flxkrmr/eec-iv-reader-arduino/pcb/EEC-IV-Reader.png

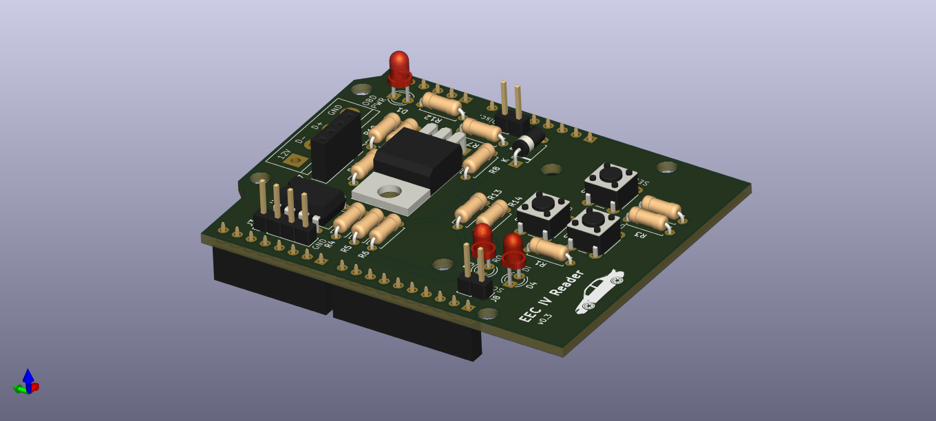
pcb/EEC-IV-Reader.png
