flxkrmr/eec-iv-reader-arduino/README.md

# Arduino EEC IV Reader

Arduino implementation of the DCL-Protocol to communicate with Ford EEC-IV ECUs.

Please check out the Wiki for more information.

This is currently a work in progress and not completely working. Use at your own risk!

Finished Board
