flxkrmr/eec-iv-reader-arduino/src/README.md

# Arduino EEC IV Reader

Arduino implementation of the DCL-Protocol to communicate with Ford EEC-IV ECUs.

Mostly based on findings of this implementation https://github.com/babroval/ford-eec-iv-diagnostic

This is currently a work in progress and not completely working. Use at your own risk!

## TODO
* Move UI code to class
* Refactor EecIv class
* Timeout for reading
* Read live values
* How to read multiple fault codes?
