flxkrmr/eec-iv-reader-arduino/(threads)

Thread 1 (2022-02-24):

hardware to read eec

fmcwb, 2022-02-24:
Hi flxkrmr,

what hardware are you using to test the eec-iv protocol? I have arduino mega 2560 for use, to using more UARTS...

I see you using the tft display... I intend to use the serial to handle the read data.

Thank You.

flxkrmr, 2022-02-25:
Hi,
currently I am using a Arduino uno attached to a rs485 board. As the uno only has one serial modul I wanted to attach a display to get some reading. But over the time I switched to using arduinos software serial as it is easier to time right for the eec iv ecu. This is why I also switched back to usb-serial output for debugging.
At the moment this is still in a very early development stage and thats why I don't want to add any circuits or manuals on how to set this up (yet). But as you can see in the main ino file, these are the pins that I currently use for the RS485 module:

```
static const int DI=3;
static const int RE=6;
static const int RO=2;
```

Closed 2022-10-07.

Thread 2 (2022-10-07):

Create circuit

flxkrmr, 2022-10-07:
To Test:
- [x] Original Board
- [x] Power Cirucit
- [x] RS485 Cirucit

flxkrmr, 2022-10-07:
Findings from tests:
* Add jumper to detach obd2 power supply for USB Power supply

Closed 2022-10-07.

Thread 5 (2022-10-23):

Improvements for Board v3

flxkrmr, 2022-10-23:
Parts:
- [x] Brückchen
- [x] Better Sockets for display
- [x] Spacers for display

Board:
- [x] Resistor names next so resistors and not under
- [x] Print name and symbol on board
- [x] Add on off switch (maybe?)
- [x] Solder points instead of screw terminals for obd cable
- [x] Led for incoming signal like logic analyzer (with label)
- [x] Lables on pin bars (debug i2c and so an)
- [x] Version on Board

Closed 2022-12-31.

Thread 8 (2022-10-28):

Readable Fault codes

flxkrmr, 2022-10-28:

flxkrmr, 2022-10-30:
Due to the limited ram of the arduino uno, it is not possible to put all the fault code strings into the code.

It could work if we switch to an arduino mega board with 4 times the memory, but that is not planned for now

Closed 2022-10-30.

Thread 15 (2023-01-08):

Display stops working occasionally

flxkrmr, 2023-01-08:

flxkrmr, 2023-02-06:
The seems to be a problem with the display. Maybe improve connection or add 4 spacers.

flxkrmr, 2023-03-18:
This might be a bigger issue, as it occurs often when testing in the car.

Thread 17 (2023-01-21):

Switch to ABLE Buttons to save memory

flxkrmr, 2023-01-21:
https://www.jsware.io/able-buttons/#:~:text=Memory%20Usage,-The%20AbleButtons%20basic&text=Maximum%20is%2030720%20bytes.,Arduino's%20built%2Din%20Debounce%20example.

Closed 2023-01-26.

Thread 23 (2023-02-06):

Add reverse polarity protection

flxkrmr, 2023-02-06:

flxkrmr, 2023-02-06:
- Reverse polarity protection
- esd protection
- gpio led
- smd parts??

Thread 25 (2023-02-17):

Need to implement parity checking for UART messages

mercury64, 2023-02-17:
As an example, the UART command to start CART is 0x4.
The module id is 0x1, the EEC node on the bus.
The last byte is the parity check byte.
Simply AND all the bytes together:
0x00...0x01, 0x04, 0x00, 0x00, 0x00 = 0x05

Command 0x04 go into CART mode.
Command 0x05 is use alternate calibration.
Command 0x80 is go permanently offline
Command 0x82 is echo module id

flxkrmr, 2023-02-17:
Do you mean the start message mentioned here https://github.com/flxkrmr/eec-iv-reader-arduino/issues/24?

These commands are interesting! Do you have more informations about the UART mode or some documents?

mercury64, 2023-02-18:
Yes, I have documents, as well as I have decompiled my EEC and have the code that runs on the EEC.

Thread 27 (2023-02-17):

Allow ECUs that start with 19200 bauds

flxkrmr, 2023-02-17:

mercury64, 2023-02-18:
As far as I know, the initial UART message starts at 2400 baud for all.
The request is made to put in CART mode 0x04 using 2400 baud.
Then depending on the EEC strategy configuration, CART mode is at 19200 baud.
Once in CART mode, the baud can be changed 2400,  4800, 9600, or 19200.
Command code 0x81, DCL_DM_SetCommLinkBAUDRate                  # Set DCL baud rate
in CART mode changes the EEC baud rate.

flxkrmr, 2023-02-18:
The code currently only works with CART mode that starts with 9600 baud and is has trouble with units that start CART mode with 19200 baud. After CART initialisation it always switched baud rate to 2400 for all diagnostic communication.

Do you know if all diagnostic commands work with all baud rates? I had trouble getting the error codes with 9600 baud, but I found nothing about this in the docs.

mercury64, 2023-02-18:
UART mode is only 2400.
You can only start CART mode in UART mode at 2400.
CART mode will start in whatever the EEC is programmed to.
CART mode can be changed once in this mode to 2400, 4800, 9600, or 19200.

I am unable to get any communication happening right now, probably a noisy circuit.

flxkrmr, 2023-02-19:
In my tests the communication seemed very resistant against noise or bad cable connections. Maybe check the delays between bytes and IWs. The EEC IV is more unforgiving with these

mercury64, 2023-02-20:
EEC-IV hardware code SME-105, software code ENVY once in cart mode starts in 9600.

What hardware code you have, and software code?

I can decompile for you, and show the code in the EEC.
UART command code 0x04= GO CART MODE:
`5a6d: d7,19               jne   5a88             if (R33 = 4)  {
5a6f: 91,08,df            orb   Rdf,8            B3_Rdf = 1;
5a72: b1,02,32            ldb   R32,2            R32 = 2;`
R32 = 2 = 0x2H = 9600baud
# 00H                2400 baud
# 01H                4800 baud
# 02H                9600 baud
# 03H               19200 baud

flxkrmr, 2023-02-20:
How do I find the hardware- and software-code?

mercury64, 2023-02-20:
Software code, or calibration is the 3 or 4 digit bold uppercase letters and numbers located on the actual EEC label.
The hardware code is not bold, can start with SME-xxxx, SDxxxx, MAF-xxxx, MLP-xxx, etc.

Post a picture of your EEC-IV label.

flxkrmr, 2023-02-21:
My main testing ECU is VANE SME-401. This one starts in 9600 baud.
The ECU that starts in 19200 is BEAU SME-105.
And lastly one ECU that does not answer at all is 2GEA EST-230

mercury64, 2023-02-22:
The 2GEA EFI-SD230 must have the 81C62 chip.
More than likely it only has  81C61 chip.
For DCL needs the second crystal that runs at 4.9152Mhz and the 81C62 CART chip.

I'll try and find the VANE and BEAU bins and will disassemble them with DCL UART/CART info. I will check in my own repository and will create a pull request.

mercury64, 2023-02-22:
Here is first commit of disassembled SME-401.
Have a read, I will update it more later.
It is fairly well commented.

Here are some links:
External Interupt from UART/CART serial data
https://github.com/mercury64/eec-iv-reader-arduino/blob/master/hardware/SME-401/SEAL_lst.txt#L5742

UART MODE
https://github.com/mercury64/eec-iv-reader-arduino/blob/master/hardware/SME-401/SEAL_lst.txt#L5754

CART MODE
https://github.com/mercury64/eec-iv-reader-arduino/blob/master/hardware/SME-401/SEAL_lst.txt#L5829

DEFINED EEC-IV DIAGNOSTIC MODES
https://github.com/mercury64/eec-iv-reader-arduino/blob/master/hardware/SME-401/SEAL_lst.txt#L6316

flxkrmr, 2023-02-22:
Damn, thats interesting. Thanks for this. Event though I'm not so good at reading assembler, I think I can pull some infos out of this

mercury64, 2023-02-22:
Comments are on the right hand side. I only commented the DCL stuff. I copied it from my EEC-IV SD48b KID2 v8 351w E4OD(Canadian). I've been disassembling it for about 3 years. The DCL code is near identical.
I'll push my documentation.

Thread 29 (2023-02-23):

Continuous Memory Errors are deleted after KOEO run

flxkrmr, 2023-02-23:
It seems that all Errors in the Continuous Test Memory (Diagnostic mode 0x26) are delete after running the KOEO test (0x25).

@mercury64 Do you by any chance know something about this?

mercury64, 2023-02-24:
First thought is, that continuous memory codes are stored in Keep Alive Memory(KAM), yellow power wire on EEC.
If power is disconnected, the codes are gone.
Give me a few days, I finally have communication going with correct delays, CART mode working with UNO and software serial.
I'll test it over this weekend.

flxkrmr, 2023-02-24:
Power is not disconnected, so this should not be the problem.

I just found something in one of your documents, which might be the cause:
"If STI is ungrounded during the output of codes in Engine Off Test, all continuous
      self  test  codes are erased from KAM.  This allows for repair verification by the
      mechanic."

All tests where run on Ford Mondeo mk1 where STI is not connected at all

mercury64, 2023-02-24:
Yup, that would explain that.
Here is a link to more documentation:
https://drive.google.com/drive/folders/1UnA8qP_5oNhmdacBlSEwCUKwn0QFDHdr

flxkrmr, 2023-02-24:
Thanks!

Closed 2023-02-24.
