flxkrmr/eec-iv-reader-arduino/pcb/schematic.pdf

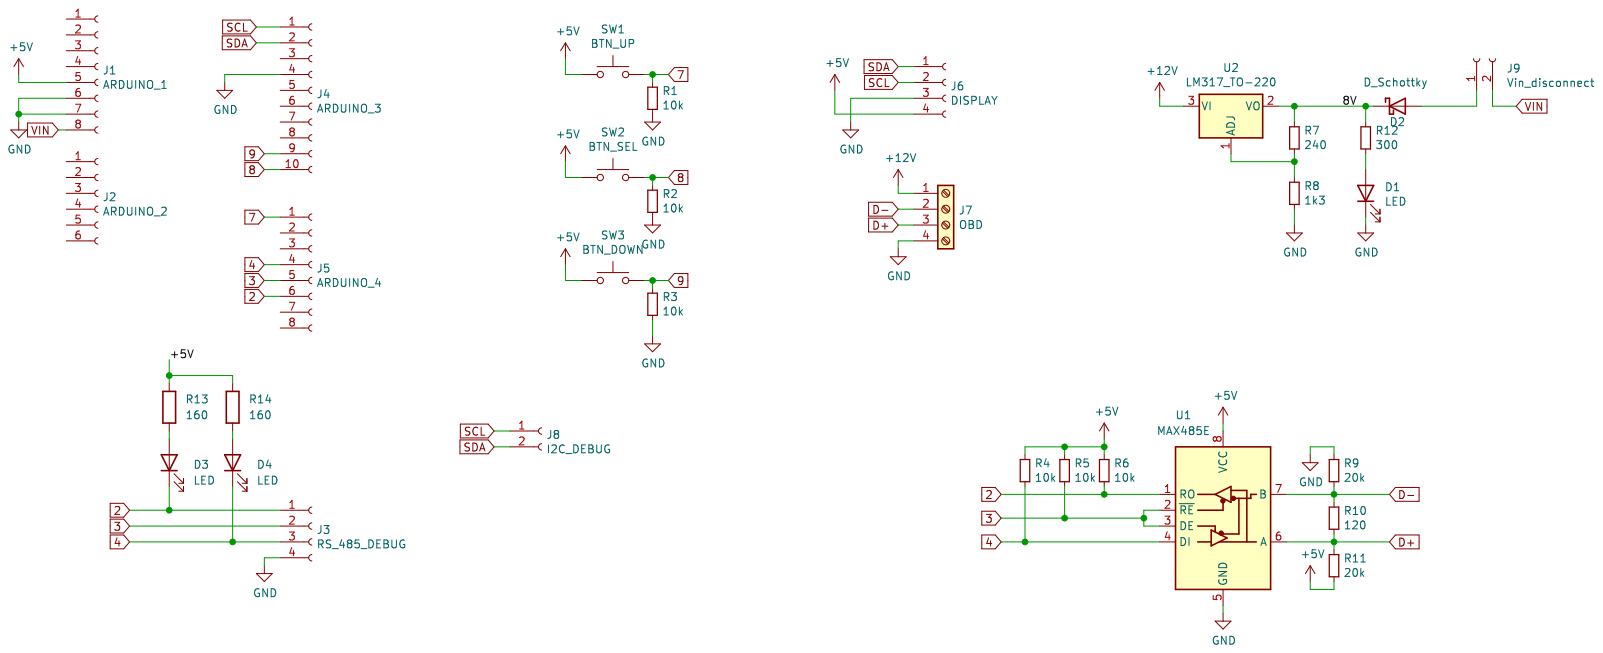
[picture p2: page 1]
