flxkrmr/eec-iv-reader-arduino/pcb/EEC-IV-Reader.kicad_pcb

## KiCad design pcb/EEC-IV-Reader.kicad_pcb (2023-01-20)

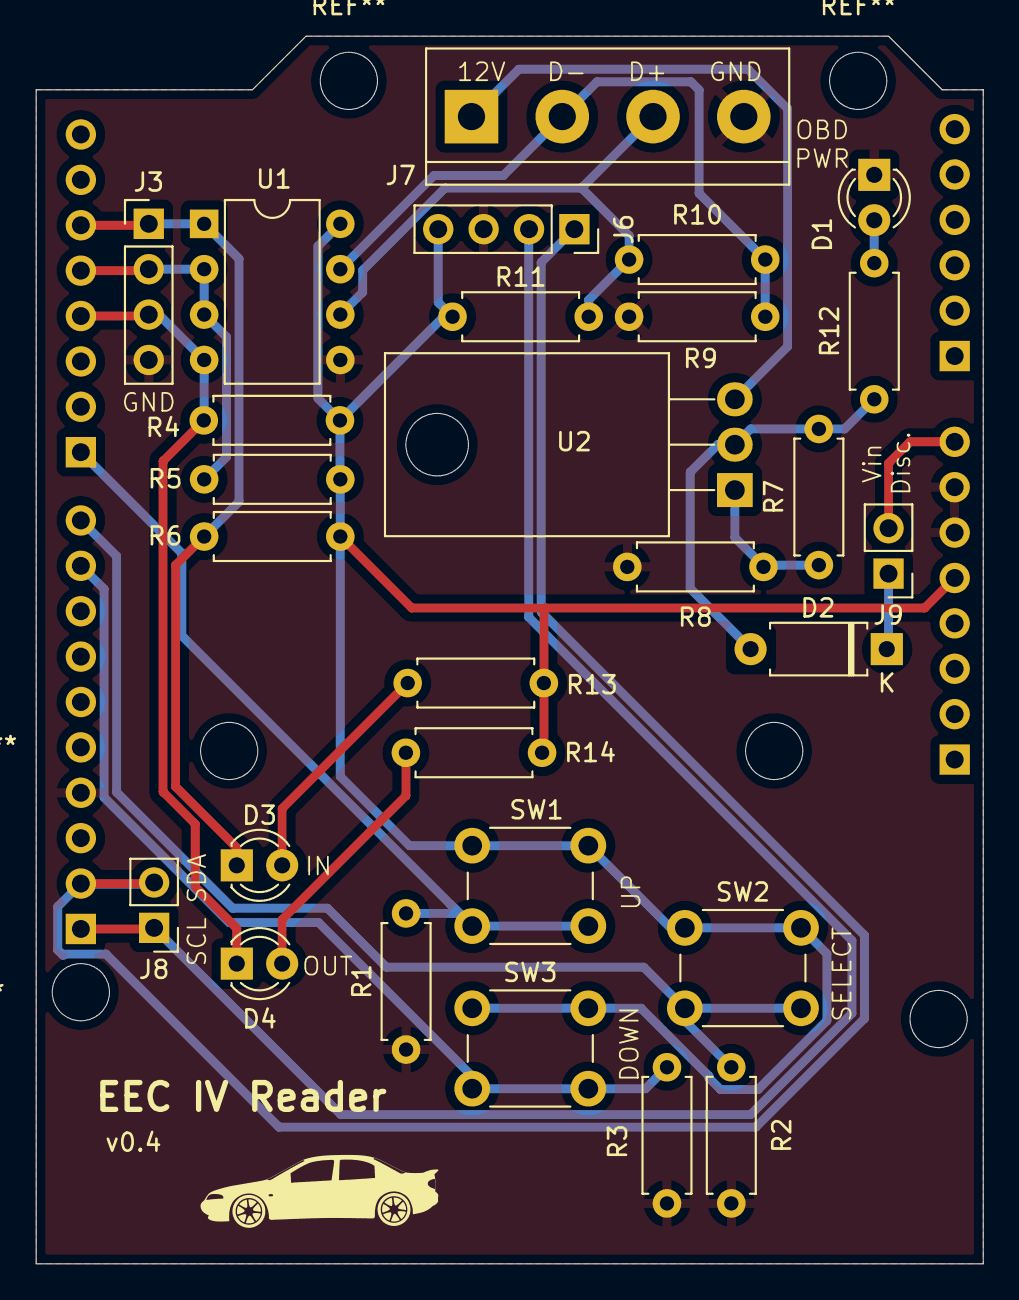
[picture p3: board EEC-IV-Reader.kicad_pcb from above]

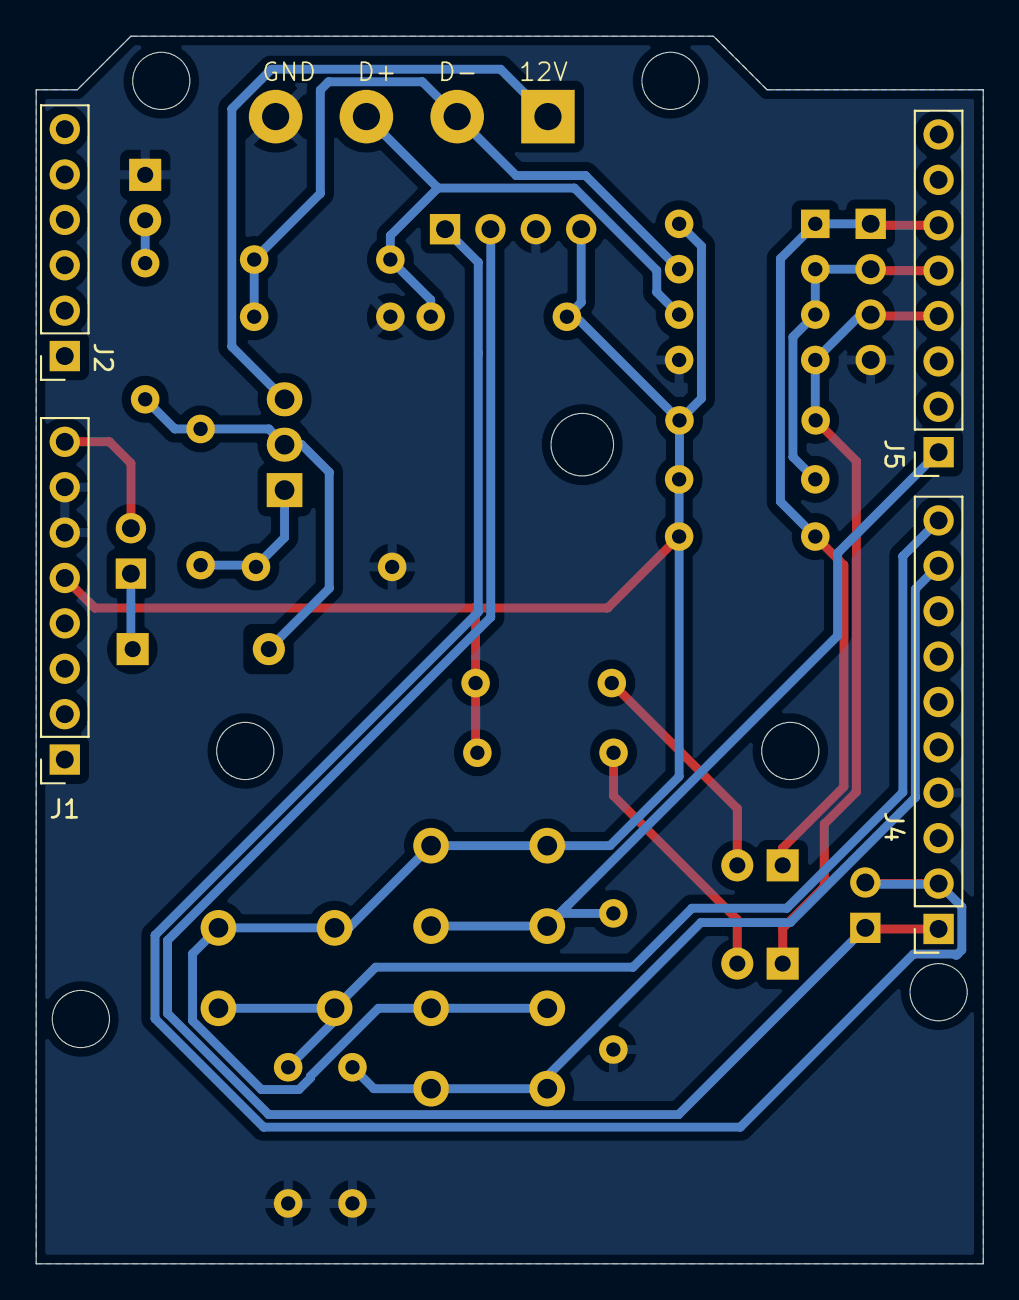
[picture p4: board EEC-IV-Reader.kicad_pcb from below]

Board: 2 copper layers, 53.0 x 68.7 mm, 32 parts (4 on the bottom side), 20 nets.

Parts:
D1, D3, D4: LED; LED_D3.0mm
D2: D_Schottky; D_A-405_P7.62mm_Horizontal
J1: ARDUINO_1; PinSocket_1x08_P2.54mm_Vertical
J2: ARDUINO_2; PinSocket_1x06_P2.54mm_Vertical
J3: RS_485_DEBUG; PinHeader_1x04_P2.54mm_Vertical
J4: ARDUINO_3; PinSocket_1x10_P2.54mm_Vertical
J5: ARDUINO_4; PinSocket_1x08_P2.54mm_Vertical
J6: DISPLAY; PinSocket_1x04_P2.54mm_Vertical
J7: OBD; TerminalBlock_bornier-4_P5.08mm
J8: I2C_DEBUG; PinHeader_1x02_P2.54mm_Vertical
J9: Vin_disconnect; PinHeader_1x02_P2.54mm_Vertical
R1, R2, R3, R4, R5, R6: 10k; R_Axial_DIN0207_L6.3mm_D2.5mm_P7.62mm_Horizontal
R7: 240; R_Axial_DIN0207_L6.3mm_D2.5mm_P7.62mm_Horizontal
R8: 1k3; R_Axial_DIN0207_L6.3mm_D2.5mm_P7.62mm_Horizontal
R9, R11: 20k; R_Axial_DIN0207_L6.3mm_D2.5mm_P7.62mm_Horizontal
R10: 120; R_Axial_DIN0207_L6.3mm_D2.5mm_P7.62mm_Horizontal
R12: 300; R_Axial_DIN0207_L6.3mm_D2.5mm_P7.62mm_Horizontal
R13, R14: 160; R_Axial_DIN0207_L6.3mm_D2.5mm_P7.62mm_Horizontal
SW1: BTN_UP; SW_PUSH_6mm_H4.3mm
SW2: BTN_SEL; SW_PUSH_6mm_H4.3mm
SW3: BTN_DOWN; SW_PUSH_6mm_H4.3mm
U1: MAX485E; DIP-8_W7.62mm
U2: LM317_TO-220; TO-220-3_Horizontal_TabDown

Connections:
2: D3.1 (K), J3.1, J5.6, R6.2, U1.1 (RO)
3: J3.2, J5.5, R5.2, U1.2 (~RE), U1.3 (DE)
4: D4.1 (K), J3.3, J5.4, R4.2, U1.4 (DI)
7: J5.1, R1.1, SW1.2
8: J4.10, R2.1, SW2.2
9: J4.9, R3.1, SW3.2
+5V: J1.5, J6.4, R4.1, R5.1, R6.1, R11.2, R13.1, R14.1, SW1.1, SW2.1, SW3.1, U1.8 (VCC)
+12V: J7.1, U2.3 (VI)
/8V: D2.1 (K), R7.1, R12.1, U2.2 (VO)
D+: J7.3, R10.2, R11.1, U1.6 (A)
D-: J7.2, R9.2, R10.1, U1.7 (B)
GND: D1.1 (K), J1.6, J1.7, J3.4, J4.4, J6.3, J7.4, R1.2, R2.2, R3.2, R8.2, R9.1, U1.5 (GND)
unnamed: D1.2 (A), R12.2
unnamed: D2.2 (A), J9.1
unnamed: D3.2 (A), R13.2
unnamed: D4.2 (A), R14.2
unnamed: R7.2, R8.1, U2.1 (ADJ)
SCL: J4.1, J6.2, J8.1
SDA: J4.2, J6.1, J8.2
VIN: J1.8, J9.2
