flxkrmr/eec-iv-reader-arduino/(commit log)

2022-02-10 Fix sync answer timing
    [Rs485.cpp, Rs485.h, eev4-reader.ino]
2022-02-16 Somehow reads error code
    [Rs485.cpp, Rs485.h]
2022-02-16 Switch fully to SoftwareSerial
2022-02-17 Printing 5 error codes to serial
    [Rs485.cpp, Rs485.h, eev4-reader.ino]
2022-03-05 Add button ui
2022-04-04 Switch back to big class
2022-04-06 Switch to homemade menu
2022-10-07 Add circuit board
    [EEC-IV-Reader.csv, EEC-IV-Reader.kicad_pcb, EEC-IV-Reader.sch]
2022-10-23 Fix pin out for proto board
2022-10-28 Remove submodules and add static files
    [EECIVFaults.csv, EECIVParameters.csv]
2022-10-30 Print readable message on fault code
2022-10-30 Remove usage of readable error codes
    Memory is too low.
    [EecIvReader.cpp]
2022-10-30 Improve board
    [EEC-IV-Reader.kicad_pcb]
2022-11-04 Get out of static message with up and down button
2022-11-06 Cleanup files
    [EECIVFaults.csv, EECIVParameters.csv]
2022-12-30 Update PCB
    [EEC-IV-Reader.csv, EEC-IV-Reader.kicad_pcb, EEC-IV-Reader.kicad_sch, EEC-IV-Reader.sch]
2023-01-13 Update LED Labels and Diode direction
    [EEC-IV-Reader.kicad_pcb, EEC-IV-Reader.kicad_sch]
2023-01-13 Fix koeo for dynamic error number
    [EecIvReader.cpp]
2023-01-14 Fixing koeo again for only one error
    [EecIvReader.cpp]
2023-01-20 Add terminal labels to backside
    [EEC-IV-Reader.kicad_pcb]
2023-01-20 Add bom
2023-01-20 Fix footprint
    [EEC-IV-Reader.kicad_pcb]
2023-01-26 Fix button setup
2023-01-26 Remove wire library
2023-01-27 Add voltage divider to measure battery voltage
    [EEC-IV-Reader.kicad_sch]
2023-01-27 Add voltage measurement
2023-01-27 Fix resistor value
    [EEC-IV-Reader.kicad_sch]
2023-01-31 Revert "Delete clearing of DCL Error Flag Registers"
    This reverts commit 4e58cb0d945757c14b122edca00dc5dcedb48b1c.
    [EecIv.cpp, EecIv.h]
2023-02-01 Simplify sync and only listen to index value
    Only consider the last byte of each sync frame
2023-02-17 Add CART reset() and frameDone
    [Cart.cpp, Cart.h, EecIv.cpp, EecIv.h]
2023-02-17 Fix double koeo code
    [EecIv.cpp]
2023-02-17 Add id slot parity check
2023-02-19 Test shorter start message
    [Cart.cpp, Cart.h]
2023-02-19 Read DCL Error flags
    [Cart.cpp]
2023-02-21 Use error collecting logic for both tests
    [Cart.cpp, EecIv.cpp, EecIv.h, EecIvReader.cpp]
2023-02-23 Remove voltage monitor with define
2023-02-24 Allow cart to read multiple IWs in data slot
2023-03-02 Remove voltage reader as live data can do this
2023-03-02 Fix multiple code bug
    [EecIv.cpp, EecIvReader.cpp]
2023-03-20 Fix sync bug when engine is running
    [Cart.cpp, Cart.h]
2023-03-25 Create PID checksums on the fly
